KinDR007/esphome-susicka-maso/(commit log)

2026-10-31 Add ESPHome meat dryer controller with fan PWM/tach, HTU21D and auto mode
2026-10-31 Add long-term program timer, outage detection and runtime statistics
    Flash is written every 15 min, outage = boot time - last persisted heartbeat.
    Adds Home Assistant dashboard for long-term analysis.
2026-10-31 Add staged drying profiles with out-of-range alarms
    Biltong (warm, traditional), bresaola, fermented salami drying,
    Buendnerfleisch and pastirma. Stage parameters are written to the
    control numbers on stage change, manual steps raise an action flag.
2026-10-31 Add parametric fan drilling template and cover grille (OpenSCAD)
    [fan_grille.scad]
2026-10-31 Drive fan PWM directly from GPIO (no MOSFET)
2026-10-31 Reboot when humidity sensor has no valid reading, with backoff
2026-10-31 Add parametric HTU21D case with magnet mount and rear cable exit
    [htu21d_case.scad]
2026-10-31 HTU21D case: 0.6 mm uniform shell following cavity shape
    [htu21d_case.scad]
2026-11-01 Add Home Assistant dashboard v2 with profile guide
    Sections layout matching the redesigned overview dashboard (button-card
    blocks, sparklines, apexcharts), program stage timeline and a per-profile
    guide (meat, environment, preparation, stages, manual steps, done criteria).
    scripts/check_dashboard.py validates entity ids, profile stage tables
    against profiles.yaml and runs all button-card JS templates in node.
    [dashboard_v2.yaml]
2026-11-02 Add custom on-device web UI replacing the stock ESPHome page
    susicka_ui external component embeds a single script (/0.js) built from
    app.js, app.css and the profile guide (guide.yaml) into the firmware.
    It talks to the web server REST API and /events, so the dryer can be
    monitored and controlled without Home Assistant or internet access.
    check_dashboard.py now also verifies the web UI entity names and the
    guide data against profiles.yaml and dashboard v2. webui_dev.py serves
    the page with mock data or proxies a live device for development.
2026-11-02 Web UI: light / dark / system theme switch
    The theme is chosen in the header and remembered in the browser,
    "Auto" follows the system preference and its changes.
